multigcs/rio-tangbob/README.md

# TangBOB

cheap universal-board for LinuxCNC-RIO

* W5500
* Level-Shifter (TXS0108E)
* RGB-LED
* Modbus
* I2C - 5V (hope this will work via the level-shifter)

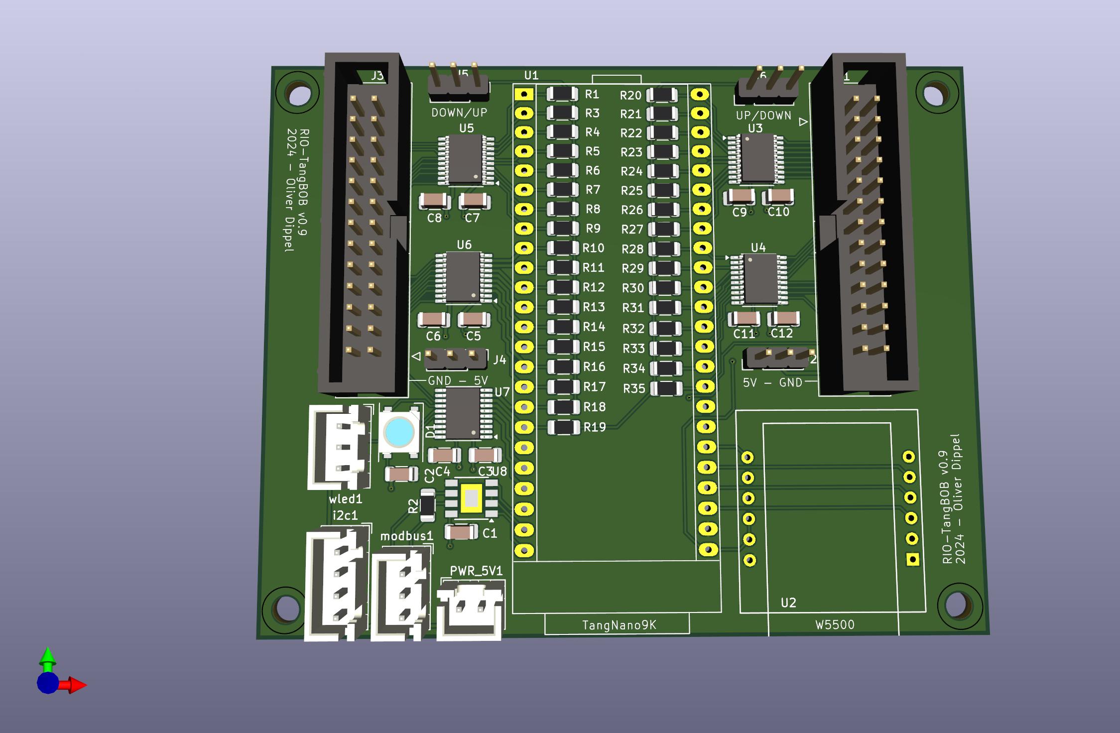
[picture p1: rio-tangbob.jpg]
rio-tangbob


Kicad-Footprint for the TangNano9K:

    https://github.com/jabadiagm/MSXmapper_tn9k/tree/main/kicad/t_mapper.pretty
