multigcs/rio-tangbob/rio-tangbob.pdf

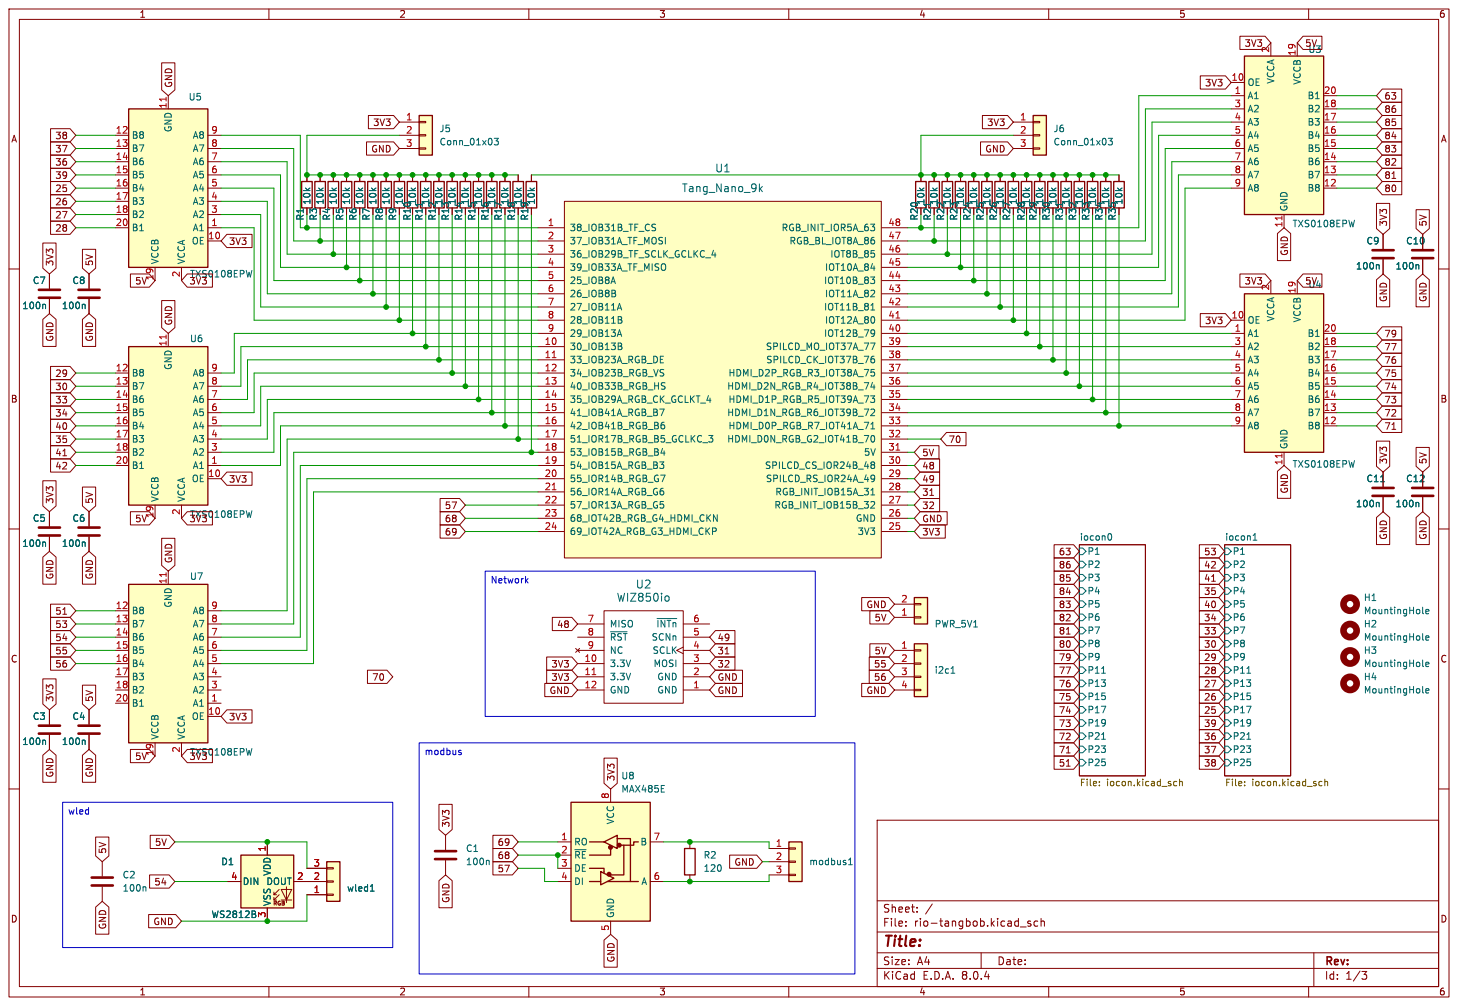
[picture p2: page 1]

2 B1 20 A2 3 A3 4 A4 5 A5 6 A6 7 A7 8 A8 9 U4 TXS0108EPW R1110k A1 1 OE 10 GND 11 B8 12 B7 13 B6 14 B5 15 B4 16 B3 17 B2 18 VCCB 19 VCCA

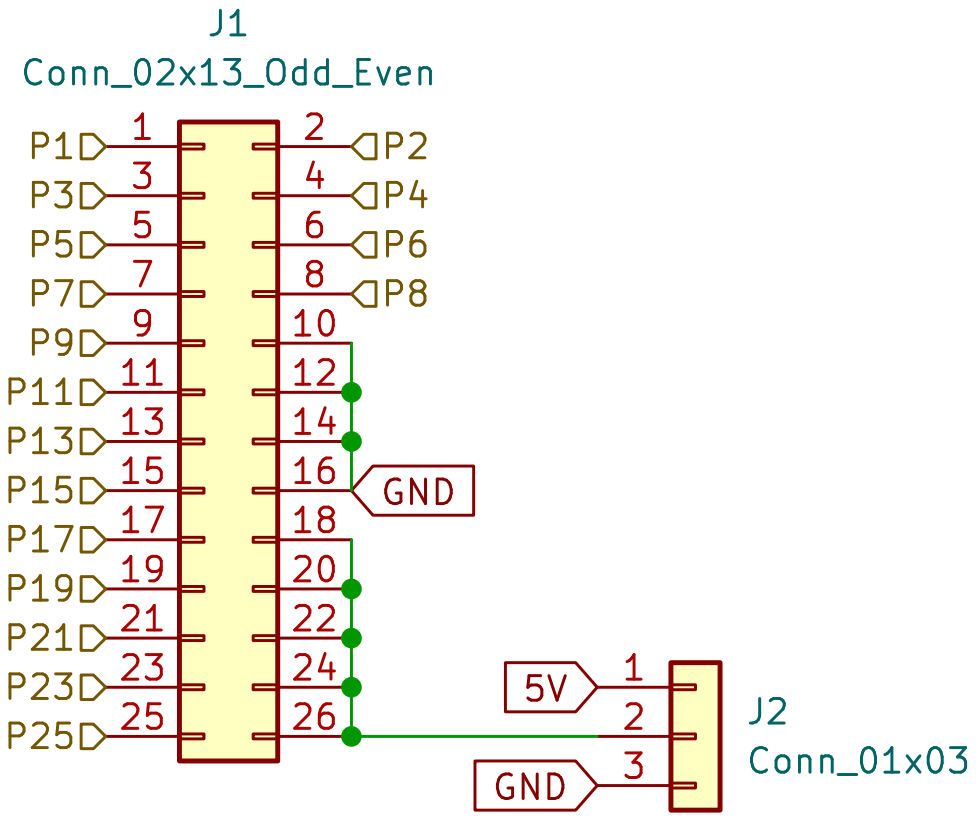
[picture p3: page 2]

Id: 2/3 Title: File: iocon.kicad_sch Sheet: /iocon0/

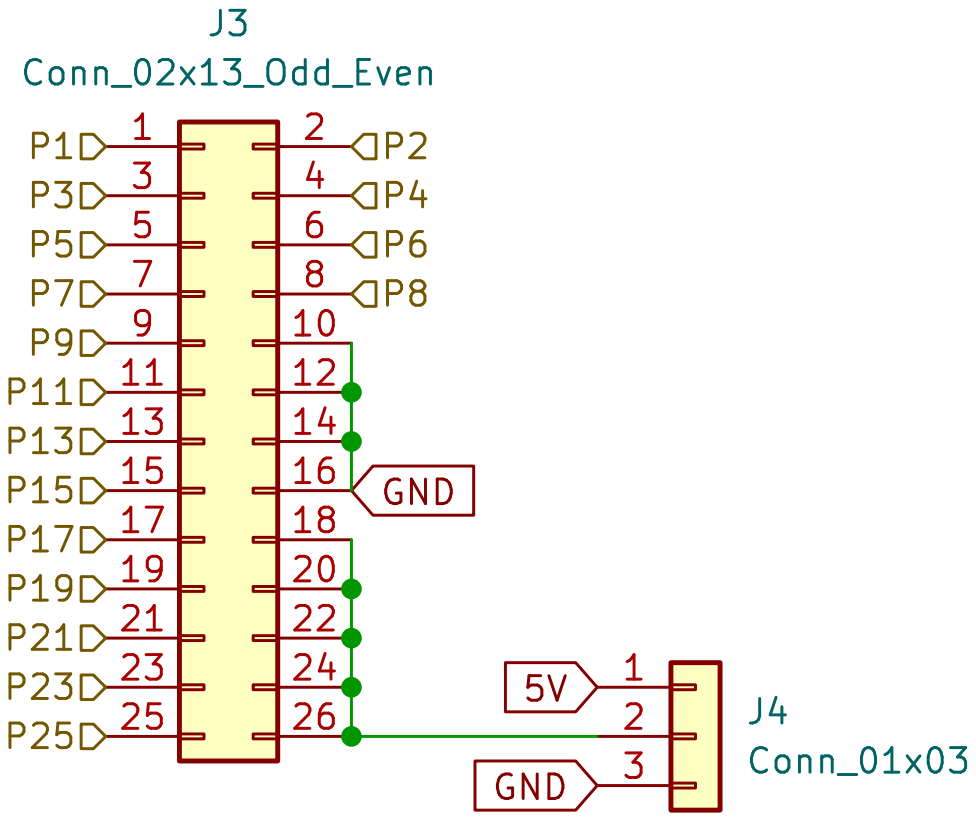
[picture p4: page 3]

Id: 3/3 Title: File: iocon.kicad_sch Sheet: /iocon1/
