multigcs/rio-tangbob/rio-tangbob.kicad_pcb

## KiCad design rio-tangbob.kicad_pcb (2024-10-09)

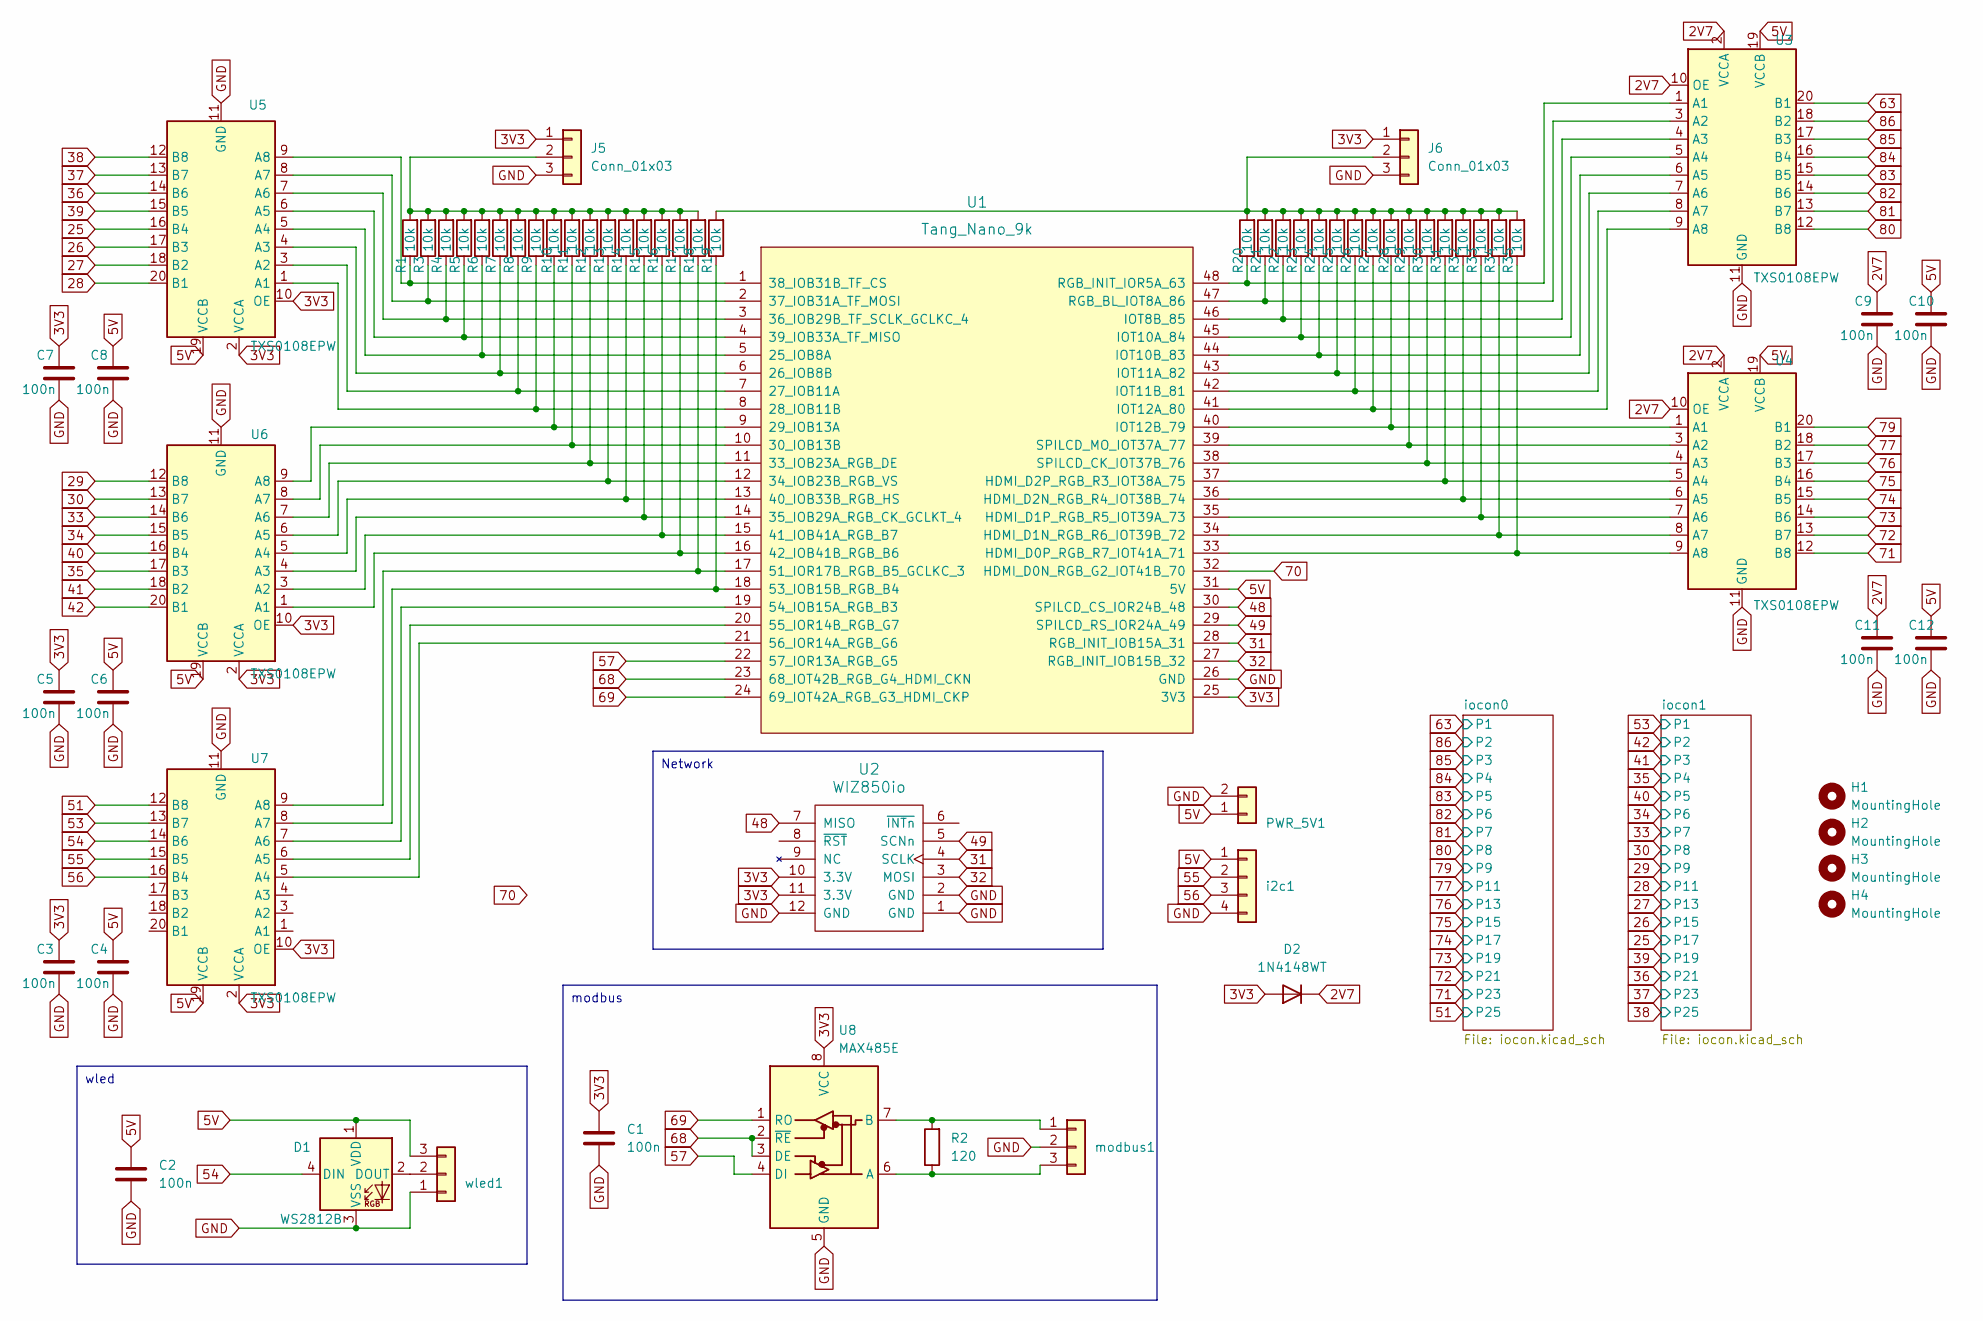
[picture p5: schematic rio-tangbob.kicad_sch]

Parts:
C1, C2, C3, C4, C5, C6, C7, C8, C9, C10, C11, C12: 100n; C_1206_3216Metric
D1: WS2812B; LED_WS2812B_PLCC4_5.0x5.0mm_P3.2mm
D2: 1N4148WT; D_SOD-523
H1, H2, H3, H4: MountingHole; MountingHole_3.2mm_M3_DIN965
J5, J6: Conn_01x03; PinHeader_1x03_P2.54mm_Vertical
PWR_5V1: Conn_01x03; JST_XH_B2B-XH-A_1x02_P2.50mm_Vertical
R1, R3, R4, R5, R6, R7, R8, R9, R10, R11, R12, R13, R14, R15, R16, R17, R18, R19, R20, R21, R22, R23, R24, R25, R26, R27, R28, R29, R30, R31, R32, R33, R34, R35: 10k; R_1206_3216Metric
R2: 120; R_1206_3216Metric
U1: Tang_Nano_9k
U2: WIZ850io
U3, U4, U5, U6, U7: TXS0108EPW; TSSOP-20_4.4x6.5mm_P0.65mm
U8: MAX485E; Diodes_SO-8EP
i2c1: Conn_01x03; JST_XH_B4B-XH-A_1x04_P2.50mm_Vertical
modbus1: Conn_01x03; JST_XH_B3B-XH-A_1x03_P2.50mm_Vertical
wled1: Conn_01x03; JST_XH_B3B-XH-A_1x03_P2.50mm_Vertical

Connections:
2V7: C9.1, C11.1, D2.1 (K), U3.2 (VCCA), U3.10 (OE), U4.2 (VCCA), U4.10 (OE)
3V3: C1.1, C3.1, C5.1, C7.1, D2.2 (A), J5.1, J6.1, U1.25 (3V3), U2.10 (3.3V), U2.11 (3.3V), U5.2 (VCCA), U5.10 (OE), U6.2 (VCCA), U6.10 (OE), U7.2 (VCCA), U7.10 (OE), U8.8 (VCC)
5V: C2.1, C4.1, C6.1, C8.1, C10.1, C12.1, D1.1 (VDD), PWR_5V1.1, U1.31 (5V), U3.19 (VCCB), U4.19 (VCCB), U5.19 (VCCB), U6.19 (VCCB), U7.19 (VCCB), i2c1.1, wled1.3; also elsewhere on the board
25: U5.16 (B4); also elsewhere on the board
26: U5.17 (B3); also elsewhere on the board
27: U5.18 (B2); also elsewhere on the board
28: U5.20 (B1); also elsewhere on the board
29: U6.12 (B8); also elsewhere on the board
30: U6.13 (B7); also elsewhere on the board
31: U1.28 (RGB_INIT_IOB15A_31), U2.4 (SCLK)
32: U1.27 (RGB_INIT_IOB15B_32), U2.3 (MOSI)
33: U6.14 (B6); also elsewhere on the board
34: U6.15 (B5); also elsewhere on the board
35: U6.17 (B3); also elsewhere on the board
36: U5.14 (B6); also elsewhere on the board
37: U5.13 (B7); also elsewhere on the board
38: U5.12 (B8); also elsewhere on the board
39: U5.15 (B5); also elsewhere on the board
40: U6.16 (B4); also elsewhere on the board
41: U6.18 (B2); also elsewhere on the board
42: U6.20 (B1); also elsewhere on the board
48: U1.30 (SPILCD_CS_IOR24B_48), U2.7 (MISO)
49: U1.29 (SPILCD_RS_IOR24A_49), U2.5 (SCNn)
51: U7.12 (B8); also elsewhere on the board
53: U7.13 (B7); also elsewhere on the board
54: D1.4 (DIN), U7.14 (B6)
55: U7.15 (B5), i2c1.2
56: U7.16 (B4), i2c1.3
57: U1.22 (57_IOR13A_RGB_G5), U8.4 (DI)
63: U3.20 (B1); also elsewhere on the board
68: U1.23 (68_IOT42B_RGB_G4_HDMI_CKN), U8.2 (~RE), U8.3 (DE)
69: U1.24 (69_IOT42A_RGB_G3_HDMI_CKP), U8.1 (RO)
70: U1.32 (HDMI_D0N_RGB_G2_IOT41B_70)
71: U4.12 (B8); also elsewhere on the board
72: U4.13 (B7); also elsewhere on the board
73: U4.14 (B6); also elsewhere on the board
74: U4.15 (B5); also elsewhere on the board
75: U4.16 (B4); also elsewhere on the board
76: U4.17 (B3); also elsewhere on the board
77: U4.18 (B2); also elsewhere on the board
79: U4.20 (B1); also elsewhere on the board
80: U3.12 (B8); also elsewhere on the board
81: U3.13 (B7); also elsewhere on the board
82: U3.14 (B6); also elsewhere on the board
83: U3.15 (B5); also elsewhere on the board
84: U3.16 (B4); also elsewhere on the board
85: U3.17 (B3); also elsewhere on the board
86: U3.18 (B2); also elsewhere on the board
GND: C1.2, C2.2, C3.2, C4.2, C5.2, C6.2, C7.2, C8.2, C9.2, C10.2, C11.2, C12.2, D1.3 (VSS), J5.3, J6.3, PWR_5V1.2, U1.26 (GND), U2.1 (GND), U2.2 (GND), U2.12 (GND), U3.11 (GND), U4.11 (GND), U5.11 (GND), U6.11 (GND), U7.11 (GND), U8.5 (GND), i2c1.4, modbus1.2, wled1.1; also elsewhere on the board
unnamed: D1.2 (DOUT), wled1.2
unnamed: J5.2, R1.2, R3.2, R4.2, R5.2, R6.2, R7.2, R8.2, R9.2, R10.2, R11.2, R12.2, R13.2, R14.2, R15.2, R16.2, R17.2, R18.2
unnamed: J6.2, R19.2, R20.2, R21.2, R22.2, R23.2, R24.2, R25.2, R26.2, R27.2, R28.2, R29.2, R30.2, R31.2, R32.2, R33.2, R34.2, R35.2
unnamed: R6.1, U1.5 (25_IOB8A), U5.5 (A4)
unnamed: R7.1, U1.6 (26_IOB8B), U5.4 (A3)
unnamed: R8.1, U1.7 (27_IOB11A), U5.3 (A2)
unnamed: R9.1, U1.8 (28_IOB11B), U5.1 (A1)
unnamed: R10.1, U1.9 (29_IOB13A), U6.9 (A8)
unnamed: R11.1, U1.10 (30_IOB13B), U6.8 (A7)
unnamed: R12.1, U1.11 (33_IOB23A_RGB_DE), U6.7 (A6)
unnamed: R13.1, U1.12 (34_IOB23B_RGB_VS), U6.6 (A5)
unnamed: R15.1, U1.14 (35_IOB29A_RGB_CK_GCLKT_4), U6.4 (A3)
unnamed: R4.1, U1.3 (36_IOB29B_TF_SCLK_GCLKC_4), U5.7 (A6)
unnamed: R3.1, U1.2 (37_IOB31A_TF_MOSI), U5.8 (A7)
unnamed: R1.1, U1.1 (38_IOB31B_TF_CS), U5.9 (A8)
unnamed: R5.1, U1.4 (39_IOB33A_TF_MISO), U5.6 (A5)
unnamed: R14.1, U1.13 (40_IOB33B_RGB_HS), U6.5 (A4)
unnamed: R16.1, U1.15 (41_IOB41A_RGB_B7), U6.3 (A2)
unnamed: R17.1, U1.16 (42_IOB41B_RGB_B6), U6.1 (A1)
unnamed: R18.1, U1.17 (51_IOR17B_RGB_B5_GCLKC_3), U7.9 (A8)
unnamed: R19.1, U1.18 (53_IOB15B_RGB_B4), U7.8 (A7)
unnamed: U1.19 (54_IOB15A_RGB_B3), U7.7 (A6)
unnamed: U1.20 (55_IOR14B_RGB_G7), U7.6 (A5)
unnamed: U1.21 (56_IOR14A_RGB_G6), U7.5 (A4)
unnamed: R35.1, U1.33 (HDMI_D0P_RGB_R7_IOT41A_71), U4.9 (A8)
unnamed: R34.1, U1.34 (HDMI_D1N_RGB_R6_IOT39B_72), U4.8 (A7)
unnamed: R33.1, U1.35 (HDMI_D1P_RGB_R5_IOT39A_73), U4.7 (A6)
unnamed: R32.1, U1.36 (HDMI_D2N_RGB_R4_IOT38B_74), U4.6 (A5)
unnamed: R31.1, U1.37 (HDMI_D2P_RGB_R3_IOT38A_75), U4.5 (A4)
unnamed: R22.1, U1.46 (IOT8B_85), U3.4 (A3)
unnamed: R23.1, U1.45 (IOT10A_84), U3.5 (A4)
unnamed: R24.1, U1.44 (IOT10B_83), U3.6 (A5)
unnamed: R25.1, U1.43 (IOT11A_82), U3.7 (A6)
unnamed: R26.1, U1.42 (IOT11B_81), U3.8 (A7)
unnamed: R27.1, U1.41 (IOT12A_80), U3.9 (A8)
unnamed: R28.1, U1.40 (IOT12B_79), U4.1 (A1)
unnamed: R21.1, U1.47 (RGB_BL_IOT8A_86), U3.3 (A2)
unnamed: R20.1, U1.48 (RGB_INIT_IOR5A_63), U3.1 (A1)
unnamed: R30.1, U1.38 (SPILCD_CK_IOT37B_76), U4.4 (A3)
unnamed: R29.1, U1.39 (SPILCD_MO_IOT37A_77), U4.3 (A2)
unnamed: R2.1, U8.6 (A), modbus1.3
unnamed: R2.2, U8.7 (B), modbus1.1

Notes on the sheet:
modbus
wled
Network

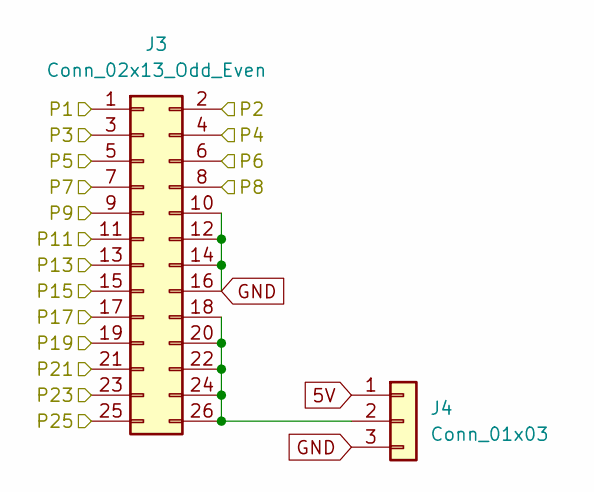
[picture p6: schematic iocon.kicad_sch]

Parts:
J3: Conn_02x13_Odd_Even; IDC-Header_2x13_P2.54mm_Vertical
J4: Conn_01x03; PinHeader_1x03_P2.54mm_Vertical

Connections:
5V: J4.1; also elsewhere on the board
25: J3.17; also elsewhere on the board
26: J3.15; also elsewhere on the board
27: J3.13; also elsewhere on the board
28: J3.11; also elsewhere on the board
29: J3.9; also elsewhere on the board
30: J3.8; also elsewhere on the board
33: J3.7; also elsewhere on the board
34: J3.6; also elsewhere on the board
35: J3.4; also elsewhere on the board
36: J3.21; also elsewhere on the board
37: J3.23; also elsewhere on the board
38: J3.25; also elsewhere on the board
39: J3.19; also elsewhere on the board
40: J3.5; also elsewhere on the board
41: J3.3; also elsewhere on the board
42: J3.2; also elsewhere on the board
53: J3.1; also elsewhere on the board
GND: J3.10, J3.12, J3.14, J3.16, J4.3; also elsewhere on the board
unnamed: J3.18, J3.20, J3.22, J3.24, J3.26, J4.2

Parts of its further copies:
J1: Conn_02x13_Odd_Even; IDC-Header_2x13_P2.54mm_Vertical
J2: Conn_01x03; PinHeader_1x03_P2.54mm_Vertical

Connections of its further copies:
5V: J2.1; also elsewhere on the board
51: J1.25; also elsewhere on the board
63: J1.1; also elsewhere on the board
71: J1.23; also elsewhere on the board
72: J1.21; also elsewhere on the board
73: J1.19; also elsewhere on the board
74: J1.17; also elsewhere on the board
75: J1.15; also elsewhere on the board
76: J1.13; also elsewhere on the board
77: J1.11; also elsewhere on the board
79: J1.9; also elsewhere on the board
80: J1.8; also elsewhere on the board
81: J1.7; also elsewhere on the board
82: J1.6; also elsewhere on the board
83: J1.5; also elsewhere on the board
84: J1.4; also elsewhere on the board
85: J1.3; also elsewhere on the board
86: J1.2; also elsewhere on the board
GND: J1.10, J1.12, J1.14, J1.16, J2.3; also elsewhere on the board
unnamed: J1.18, J1.20, J1.22, J1.24, J1.26, J2.2

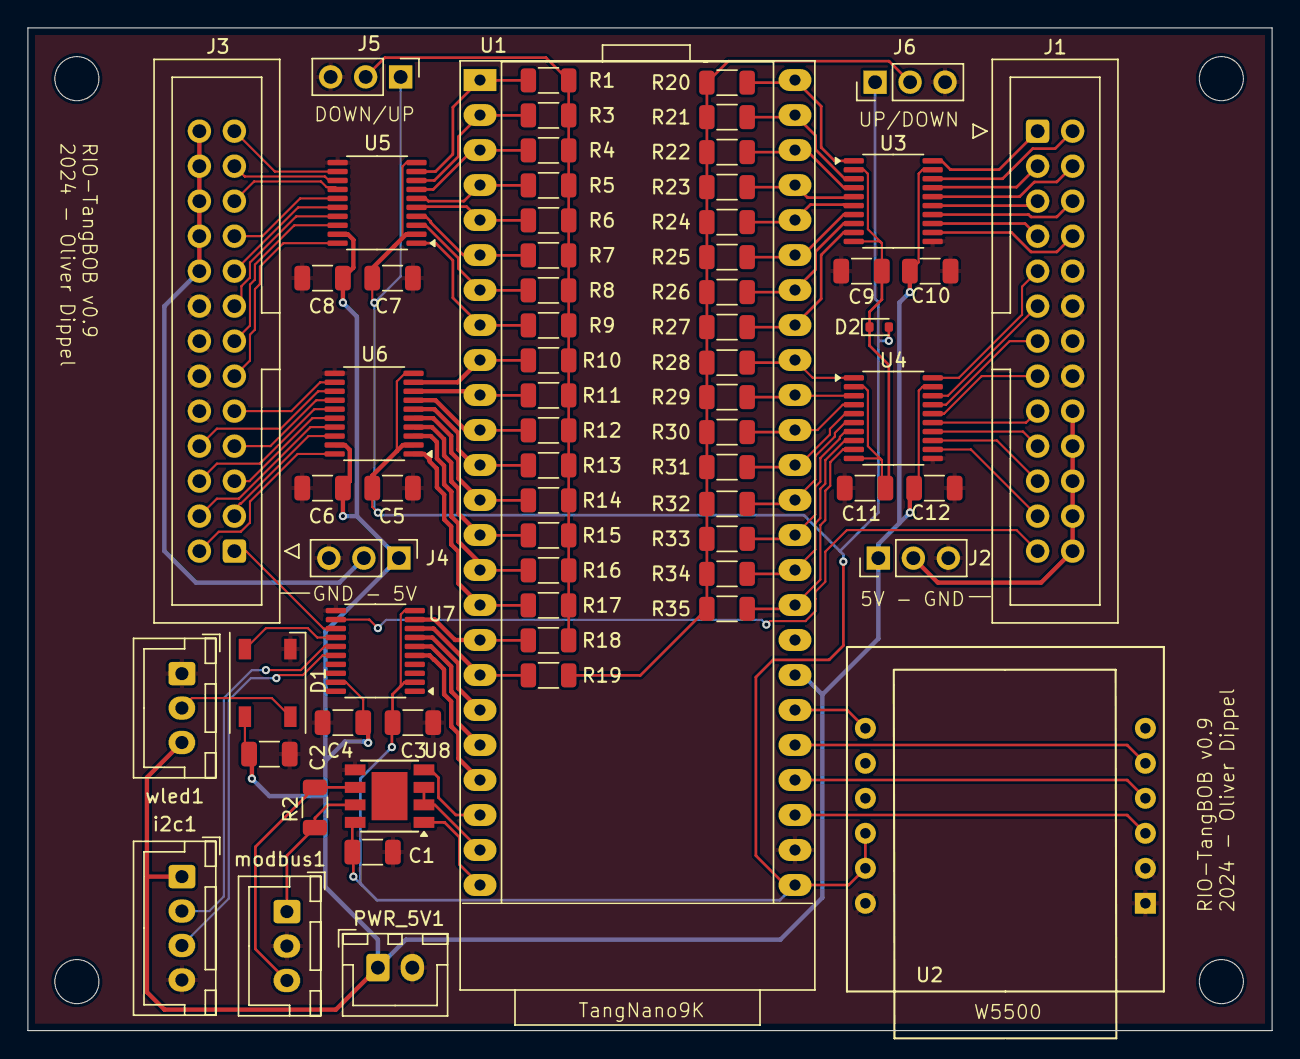
[picture p7: board rio-tangbob.kicad_pcb from above]

Board: 2 copper layers, 90.3 x 72.8 mm, 71 parts (0 on the bottom side), 92 nets.
