multigcs/rio-tangbob/(threads)

Thread 1 (2025-04-01):

Gerber error.

thihienvu516, 2025-04-01:
I'm exporting gerber  file. But error. Because i'm not ussulllly use Kicad, and make PCB, can you update/upload gerber file? I love your project. I use tang  nano 9k. Your LinuxCNC-RIO project save my machine :D

multigcs, 2025-04-01:
thanks 👍
i using Kicad9 and this tool to export all needed files:
  https://github.com/bennymeg/Fabrication-Toolkit

but i have added this files to the repo now:
  https://github.com/multigcs/rio-tangbob/tree/main/production

Closed 2025-04-01.
