multigcs/rio-tangbob/(commit log)

2024-08-18 initial release
    [iocon.kicad_sch, rio-tangbob.kicad_pcb, rio-tangbob.kicad_sch]
2024-08-18 adding pdf schematics
2024-10-09 set U3+U4 voltage to ~2.7V
    [iocon.kicad_sch, rio-tangbob.kicad_pcb, rio-tangbob.kicad_sch]
2025-04-01 adding fabrication files
    [bom.csv, designators.csv, positions.csv]
